CHILATRA/proyecto-final/montaje fisico.jpg

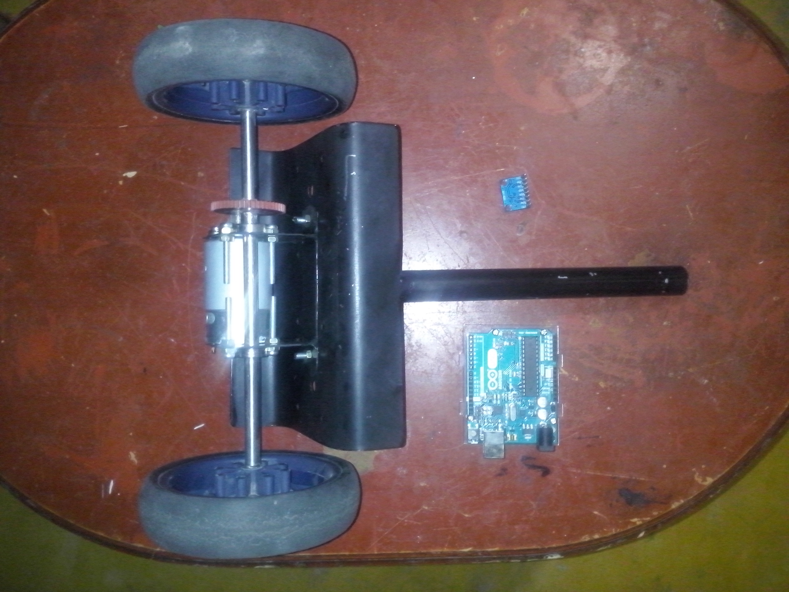
montaje fisico.jpg
