CHILATRA/proyecto-final/README.md

# proyecto-final
julian david chilatra osorno
andres felipe arango 
cristian arredondo
