CHILATRA/proyecto-final/modelo segway.docx

Péndulo invertido

Ilustración 1 péndulo invertido

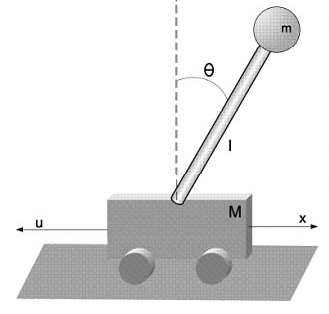
[picture p26: figure]

http://www.scielo.cl/scielo.php?script=sci_arttext&pid=S0718-07642007000500011

Modelo no lineal:

X =1/(γ_m +l*sin⁡(θ))[F/m-θ^2 l*sin(θ)-g*cos(θ)*sin⁡(θ)]

θ=1/(l(γ_m +sin⁡(θ)))[-F/mcos(θ)-θ^2 l*sin(θ)cos(θ)+(1+γ_m )g*sin(θ)]

Modelo lineal en variables de estado.

[X_1 X_2 X_3 X_4 ]=[ 0, 1, 0, 00, 0, -g/(γ_m), 000, 00, 0 , 1(g(1+γ_m ))/(l*γ_m), 0][X_1 X_2 X_3 X_4 ]+[01/(m*γ_m)0-1/(ml*γ_m)]u

Dónde:

Variable de estado | Variable física
X_1 | X
X_2 | X
X_3 | θ
X_4 | θ

Variable | Significado
U | Entrada del sistema “fuerza aplicada al carro”
m | Masa del péndulo
M | Masa del carro
l | Longitud del péndulo
X | Distancia recorrida por el carro respecto a un punto de referencia
θ | Angulo del péndulo respecto a un eje vertical
g | Aceleración gravitacional de la tierra
γ_m | Relación entre la mase del carro y la del péndulo M/m
