CHILATRA/proyecto-final/(commit log)

2015-11-09 codigo en arduino para verificar que el sensor si funciona correctamente y mover el carro
    [mover_carro.ino]
2015-11-09 modelo base para controlar el sistema
2015-11-17 ya se estan haciendo pruebas fisicas con el control
